Hanan-Lu/TPA311x/BOM/BOM.xlsx

Item Number | Part Number | Description | Value | Footprint | Quantity | Part Reference | Manufacturer1 | Manufacturer1 PN | Manufacturer1 Datasheet | Manufacturer2 | Manufacturer2 PN | Manufacturer2 Datasheet | Manufacturer3 | Manufacturer3 PN | Manufacturer3 Datasheet | Manufacturer4 Datasheet | Manufacturer4 | Manufacturer4 PN
1 | 01.01.000578 | THICK FILM CHIP RESISTORS, 0R, 1%, 1/10W, EIA 0603 | 0R/1% | 0603 | 6 | R13,R14,R15,R20,R24,R25 | RALEC | RTT030000FTP | https://www.ralec.com/upload/media/product/file/IE-SP-007.pdf | YAGEO
2 | 01.01.000675 | THICK FILM CHIP RESISTORS, 10R, 1%, 1/10W, EIA 0603 | 10R/1% | 0603 | 4 | R1,R2,R3,R4 | RALEC | RTT0310R0FTP | https://www.ralec.com/upload/media/product/file/IE-SP-007.pdf | YAGEO | RE0603FRE0710RL | https://www.yageo.com/upload/media/product/products/datasheet/rchip/PYu-RE_105_RoHS_L_6.pdf
3 | 01.01.000867 | THICK FILM CHIP RESISTORS, 1.00k, 1%, 1/10W, EIA 0603 | 1.00K/1% | 0603 | 2 | R28,R31 | RALEC | RTT031001FTP | https://www.ralec.com/upload/media/product/file/IE-SP-007.pdf | YAGEO | RE0603FRE071KL | https://www.yageo.com/upload/media/product/products/datasheet/rchip/PYu-RE_105_RoHS_L_6.pdf
4 | 01.01.000963 | THICK FILM CHIP RESISTORS, 10k, 1%, 1/10W, EIA 0603 | 10K/1% | 0603 | 4 | R36,R38,R56,R57 | RALEC | RTT031002FTP | https://www.ralec.com/upload/media/product/file/IE-SP-007.pdf | YAGEO | RE0603FRE0710KL | https://www.yageo.com/upload/media/product/products/datasheet/rchip/PYu-RE_105_RoHS_L_6.pdf
5 | 01.01.000992 | THICK FILM CHIP RESISTORS, 20k, 1%, 1/10W, EIA 0603 | 20K/1% | 0603 | 5 | R11,R40,R44,R51,R53 | RALEC | RTT032002FTP | https://www.ralec.com/upload/media/product/file/IE-SP-007.pdf | YAGEO | RE0603FRE0720KL | https://www.yageo.com/upload/media/product/products/datasheet/rchip/PYu-RE_105_RoHS_L_6.pdf
6 | 01.01.001059 | THICK FILM CHIP RESISTORS, 100k, 1%, 1/10W, EIA 0603 | 100K/1% | 0603 | 18 | R12,R16,R17,R18,R21,R22,R23,R26,R29,R30,R42,R43,R46,R47,R49,R50,R52,R54 | RALEC | RTT031003FTP | https://www.ralec.com/upload/media/product/file/IE-SP-007.pdf | YAGEO | RE0603FRE07100kL | https://www.yageo.com/upload/media/product/products/datasheet/rchip/PYu-RE_105_RoHS_L_6.pdf
7 | 01.01.003140 | THICK FILM CHIP RESISTORS, 0R, 1%, 3.5A, EIA 1206 | 0R/1% | 1206 | 2 | R34,R35 | RALEC | RTT060000FTP | https://www.ralec.com/upload/media/product/file/IE-SP-008.pdf
8 | 01.01.005319 | THICK FILM CHIP RESISTORS, 3.3R, 1%, 1/16W, EIA 0603 | 3.3R/1% | 0603 | 4 | R5,R6,R7,R8 | RALEC | RTT033R30FTP | https://www.ralec.com/upload/media/product/file/IE-SP-007.pdf
9 | 01.01.005377 | THICK FILM CHIP RESISTORS, 4.7k, 1%, 1/16W, EIA 0603 | 4.7k/1% | 0603 | 3 | R19,R32,R33 | RALEC | RTT034701FTP | https://www.ralec.com/upload/media/product/file/IE-SP-007.pdf
10 | 01.01.005394 | THICK FILM CHIP RESISTORS, 43k, 1%, 1/16W, EIA 0603 | 43k/1% | 0603 | 1 | R10 | RALEC | RTT034302FTP | https://www.ralec.com/upload/media/product/file/IE-SP-007.pdf
11 | 01.01.005396 | THICK FILM CHIP RESISTORS, 51k, 1%, 1/16W, EIA 0603 | 51k/1% | 0603 | 1 | R9 | RALEC | RTT035102FTP | https://www.ralec.com/upload/media/product/file/IE-SP-007.pdf
12 | 01.01.005397 | THICK FILM CHIP RESISTORS, 56k, 1%, 1/16W, EIA 0603 | 56k/1% | 0603 | 2 | R37,R39 | RALEC | RTT035602FTP | https://www.ralec.com/upload/media/product/file/IE-SP-007.pdf
13 | 01.01.005404 | THICK FILM CHIP RESISTORS, 180k, 1%, 1/16W, EIA 0603 | 180k/1% | 0603 | 2 | R41,R45 | RALEC | RTT031803FTP | https://www.ralec.com/upload/media/product/file/IE-SP-007.pdf
14 | 01.01.005708 | Rotary Potentiometers, RK09L12B0-F15-C0-B503, For Vol, ±20%, L=15mm, Horizon, RK09L12B0 | RK09L12B0-F15-C0-B503 | RK09L12 | 1 | VR1 | ALPS | RK09L12B0-F15-C0-B503 | https://tech.alpsalpine.com/prod/c/pdf/potentiometer/rotarypotentiometers/rk09l/rk09l.pdf
15 | 01.02.000094 | GP MLCC, 1uF, 16V, 10%, X7R, EIA 0603 | 1uF/16V | 0603 | 2 | C23,C24 | Samaung | CL10B105KO8NNN | http://weblib.samsungsem.com/mlcc/mlcc-ec-data-sheet.do?partNumber=CL10B105KO8NNN
16 | 01.02.000109 | GP MLCC, 330pF, 50V, 10%, X7R, EIA 0603 | 330pF/50V | 0603 | 4 | C2,C4,C6,C8 | Samaung | CL10B331KB8NNN | http://weblib.samsungsem.com/mlcc/mlcc-ec-data-sheet.do?partNumber=CL10B331KB8NNN
17 | 01.02.000113 | GP MLCC, 1nF, 50V, 10%, X7R, EIA 0603 | 1nF/50V | 0603 | 2 | C19,C22 | Samaung | CL10B102KB8NNN | http://weblib.samsungsem.com/mlcc/mlcc-ec-data-sheet.do?partNumber=CL10B102KB8NNN
18 | 01.02.000124 | GP MLCC, 10nF, 50V, 10%, X7R, EIA 0603 | 10nF/50V | 0603 | 4 | C13,C14,C15,C16 | Samaung | CL10B103KB8NNN | http://weblib.samsungsem.com/mlcc/mlcc-ec-data-sheet.do?partNumber=CL10B103KB8NNN
19 | 01.02.000134 | GP MLCC, 100nF, 50V, 10%, X7R, EIA 0603 | 100nF/50V | 0603 | 6 | C18,C21,C30,C47,C48,C54 | Samaung | CL10B104KB8NNN | http://weblib.samsungsem.com/mlcc/mlcc-ec-data-sheet.do?partNumber=CL10B104KB8NNN
20 | 01.02.000135 | GP MLCC, 220nF, 50V, 10%, X7R, EIA 0603 | 220nF/50V | 0603 | 6 | C1,C3,C5,C7,C33,C40 | Samaung | CL10B224KB8NNN | http://weblib.samsungsem.com/mlcc/mlcc-ec-data-sheet.do?partNumber=CL10B224KB8NNN
21 | 01.02.000140 | GP MLCC, 3.3uF/10V, 10%, X7R, EIA 0805 | 3.3uF/10V | 0805 | 4 | C26,C27,C28,C29 | Samaung | CL21B335KPFNNN | http://weblib.samsungsem.com/mlcc/mlcc-ec-data-sheet.do?partNumber=CL21B335KPFNNN
22 | 01.02.000195 | GP MLCC, 680nF/50V, 10%, X7R, EIA 0805 | 680nF/50V | 0805 | 4 | C9,C10,C11,C12 | Samaung | CL21B684KBFNNN | http://weblib.samsungsem.com/mlcc/mlcc-ec-data-sheet.do?partNumber=CL21B684KBFNNN
23 | 01.02.000235 | GP MLCC, 10uF, 50V, 10%, X7R, EIA 1206 | 10uF/50V | 1206 | 2 | C39,C46 | Samaung | CL31B106KBHNNN | http://weblib.samsungsem.com/mlcc/mlcc-ec-data-sheet.do?partNumber=CL31B106KBHNNN
24 | 01.02.000362 | GP MLCC, 22uF, 25V ±20%, X5R, EIA 0805 | 22uF/25V | 0805 | 10 | C34,C35,C36,C37,C41,C42,C43,C44,C49,C53 | Samaung | CL21A226MAYNNNE | http://weblib.samsungsem.com/mlcc/mlcc-ec-data-sheet.do?partNumber=CL21A226MAYNNN
25 | 01.02.000654 | GP MLCC, 47pF, 50V, ±5%, C0G, EIA 0603 | 47pF/50V | 0603 | 3 | C25,C38,C45 | Samaung | CL10C470JB8NFN | http://weblib.samsungsem.com/mlcc/mlcc-ec-data-sheet.do?partNumber=CL10C470JB8NFN
26 | 01.02.000773 | Radial Aluminum Electrolytic Capacitors-40~85℃, 2000H, 1000uF, 35V, 12.5X20.0mm | 1000uF/35V | 12.5X20.0 | 4 | C17,C20,C31,C32 | Panasonic | ECA1VM102 | https://industrial.panasonic.cn/cdbs/www-data/pdf/RDF0000/ABA0000C1220.pdf
27 | 01.04.000398 | SMT Shielded Power Inductor, 10uH, 30mΩ, 7.8A, 11.5x10.0x3.8mm | 10uH/7.8A | 1040 | 4 | L1,L2,L3,L4 | Cjiang | FXL1040-100-M | http://www.cjiang.tw/uploadfile/file/20190305/6368737812760517663312034.pdf | WE | 74437368100 | https://www.we-online.com/catalog/datasheet/74437368100.pdf | Sunlord | MWSA1004C-100MT | https://atta.szlcsc.com/upload/public/pdf/source/20180327/C151872_2907C77BE933212C728C209604192B1D.pdf
28 | 01.04.000413 | SMT Shielded Power Inductor, 100uH, ±20%, 0.45Ω, 0.45A, 7.0x7.0x3.2mm | 100uH/0.45A | 7032 | 2 | L5,L6 | TDK | SLF7032T-101MR45-2PF | https://product.tdk.com/system/files/dam/doc/product/inductor/inductor/smd/catalog/inductor_commercial_power_slf7032_en.pdf
29 | 01.05.000004 | Schottky Diodes, SS14, 40V, 1A, SMA(DO214AC) | SS14 | SMA | 2 | D7,D8 | ON Semiconductor | SS14 | https://www.onsemi.com/pub/Collateral/SS19-D.PDF | Vishay | SS14 | https://www.vishay.com/docs/88746/ss12.pdf
30 | 01.05.000027 | Zener Diode, 7.5V, 500mW, SOD123 | MMSZ5236BT1G | SOD-123 | 1 | D4 | ON Semiconductor | MMSZ5236BT1G | https://www.onsemi.cn/pdf/datasheet/mmsz5221bt1-d.pdf
31 | 01.05.000031 | Zener Diode, 10V, 500mW, SOD123 | MMSZ5240BT1G | SOD-123 | 2 | D3,D9 | ON Semiconductor | MMSZ5240BT1G | https://www.onsemi.cn/pdf/datasheet/mmsz5221bt1-d.pdf
32 | 01.06.000037 | LED, Side, Clear,方形, Red, 631nm, VF=2V, EIA 0603, Height=0.6mm | Red | 0603 | 3 | D6,D11,D12 | Everlight | 27-21/R6C-AP1Q2B/3C | https://everlighteurope.com/index.php?controller=attachment&id_attachment=5791 | Wurth | 155060RS75300 | https://www.we-online.com/catalog/datasheet/155060RS75300.pdf
33 | 01.06.000038 | LED, Side, Clear,方形, Green, 571nm, VF=2V, EIA 0603, Height=0.6mm | Green | 0603 | 1 | D5 | Everlight | 27-21/G6C-AN1P1/3C | https://everlighteurope.com/pcb/2725/27-21-G6C-AN1P1-3C.html | Wurth | 155060VS75300 | https://www.we-online.com/catalog/datasheet/155060VS75300.pdf
34 | 01.07.000008 | MMBT3904L, NPN Transistor, VCE饱和电压: 0.3V, Ic: 0.2A, VCEO: 40V, VCBO: 60V, VEBO: 6V, SOT23-3 | MMBT3904L | SOT-23-3 | 3 | Q1,Q2,Q3 | ON Semiconductor | MMBT3904L | https://www.onsemi.com/pub/Collateral/MMBT3904LT1-D.PDF
35 | 01.08.000180 | Single P Channel MOSFET, NCE40P13S, VBR(DS):-40V, Vgs(th):-1.7V, Id:-13A, SOP-8 | NCE40P13S | SOP-8 | 1 | Q4 | NCE | NCE40P13S | http://www.ncepower.com/upload/cn/propdf/NCE40P13S.pdf
36 | 01.09.000105 | Step Down DC-DC Converter, ME3116AM6G, VIN:4.75~40V, VFB=0.8V, IMAX=1A, SOT23-6 | ME3116AM6G | SOT23-6 | 2 | U2,U3 | MicroOne | ME3116AM6G | https://www.semiee.com/file/MicrOne/MicrOne-ME3116_C6.0.pdf
37 | 01.10.000125 | Class D Stereo Amplifier, TPA3116D2DAD, 15W/30W/50W Filter Free, With AM Avoidance, HTSSOP32-EP | TPA3116D2DAD | HTSSOP32-EP | 1 | U1 | TI | TPA3116D2DADR | https://www.ti.com.cn/cn/lit/ds/symlink/tpa3116d2.pdf
38 | 01.10.000154 | Hi-Fi Audio OP-Amp, Dual, LM4562MAX/NOPB, GBW:55MHz, VCC:5~34V, SR:±20V/us, SOIC-8 | LM4562MAX/NOPB | SOIC-8 | 1 | U4 | TI | LM4562MAX/NOPB | https://www.ti.com.cn/cn/lit/ds/symlink/lm4562.pdf
39 | 01.12.000623 | PCB Terminal Blocks, Spring Clamp System, 5.08mm, 4P, 300V, 10A, DG142R-5.08-04P | DG142R-5.08-04P | DG142R-508P-4N | 1 | J1 | Degson | DG142R-5.08-04P | https://www.degson.com.cn/index.php?a=downloadFile&id=819937&name=%27ZmlsZTQ=%27 | KEFA | KF142R-5.08-04P | http://www.cnkefa.com/ueditor/php/upload/file/20210919/1632039788290723.pdf | Amphenol | HA0401500000G | http://www.anytek.com.cn/UserUpFiles/20181025/hneMBnFDKulB.pdf
40 | 01.12.000643 | DC Power Jack, 10A, 36VDC, ID:2.5mm, OD 6.5mm | DC-053D-25A | PJ-082BH | 1 | J4 | HRO | DC-053D-25A | http://www.krhro.com/uploads/soft/180521/1-1P521151527.pdf | CUI Devices | PJ-082BH | https://www.cuidevices.com/product/resource/pj-082bh.pdf
41 | 01.12.000644 | 3.5mm Phone Jack, SMT Type, PJ-393-8A, 4 Connector, With SPST | PJ-393-8A | PJ-393-8A | 1 | J5 | HRO | PJ-393-8A | http://www.krhro.com/uploads/soft/180312/1-1P312140044.pdf
42 | 01.13.000116 | THT Push Switch, Horizon, XKBS22E05-W, No Lock, DC 50V, 0.3A, Travel 3.5mm | XKBS22E05-Z | XKBS22E05 | 1 | SW1 | XKB | XKBS22E05-Z | http://www.helloxkb.com/public/images/pdf/XKBS22E05-X.pdf
43 | 02.01.000022 | Virtual Components, M3 Screw Hole | M3 |  | 4 | M1,M2,M3,M4
44 | 02.02.000077 | Heat Sink, For TPA311x, 13.9x50x25mm, D=40mm, M3*2 | ATS-TI10P-521-C1-R1 |  | 1 | HEATSINK1 | ATS | ATS-TI10P-521-C1-R1 | https://www.qats.com/DataSheet/ATS-TI1OP-521-C1-R1
