Hanan-Lu/TPA311x/SCH/TPA3116-SCH-A0.pdf

Analog +5V And -5V SUPPLYPower IN And ON/OFF Control C33 | Audio Input And Pre-Amp -5V

# Power ON & LVP

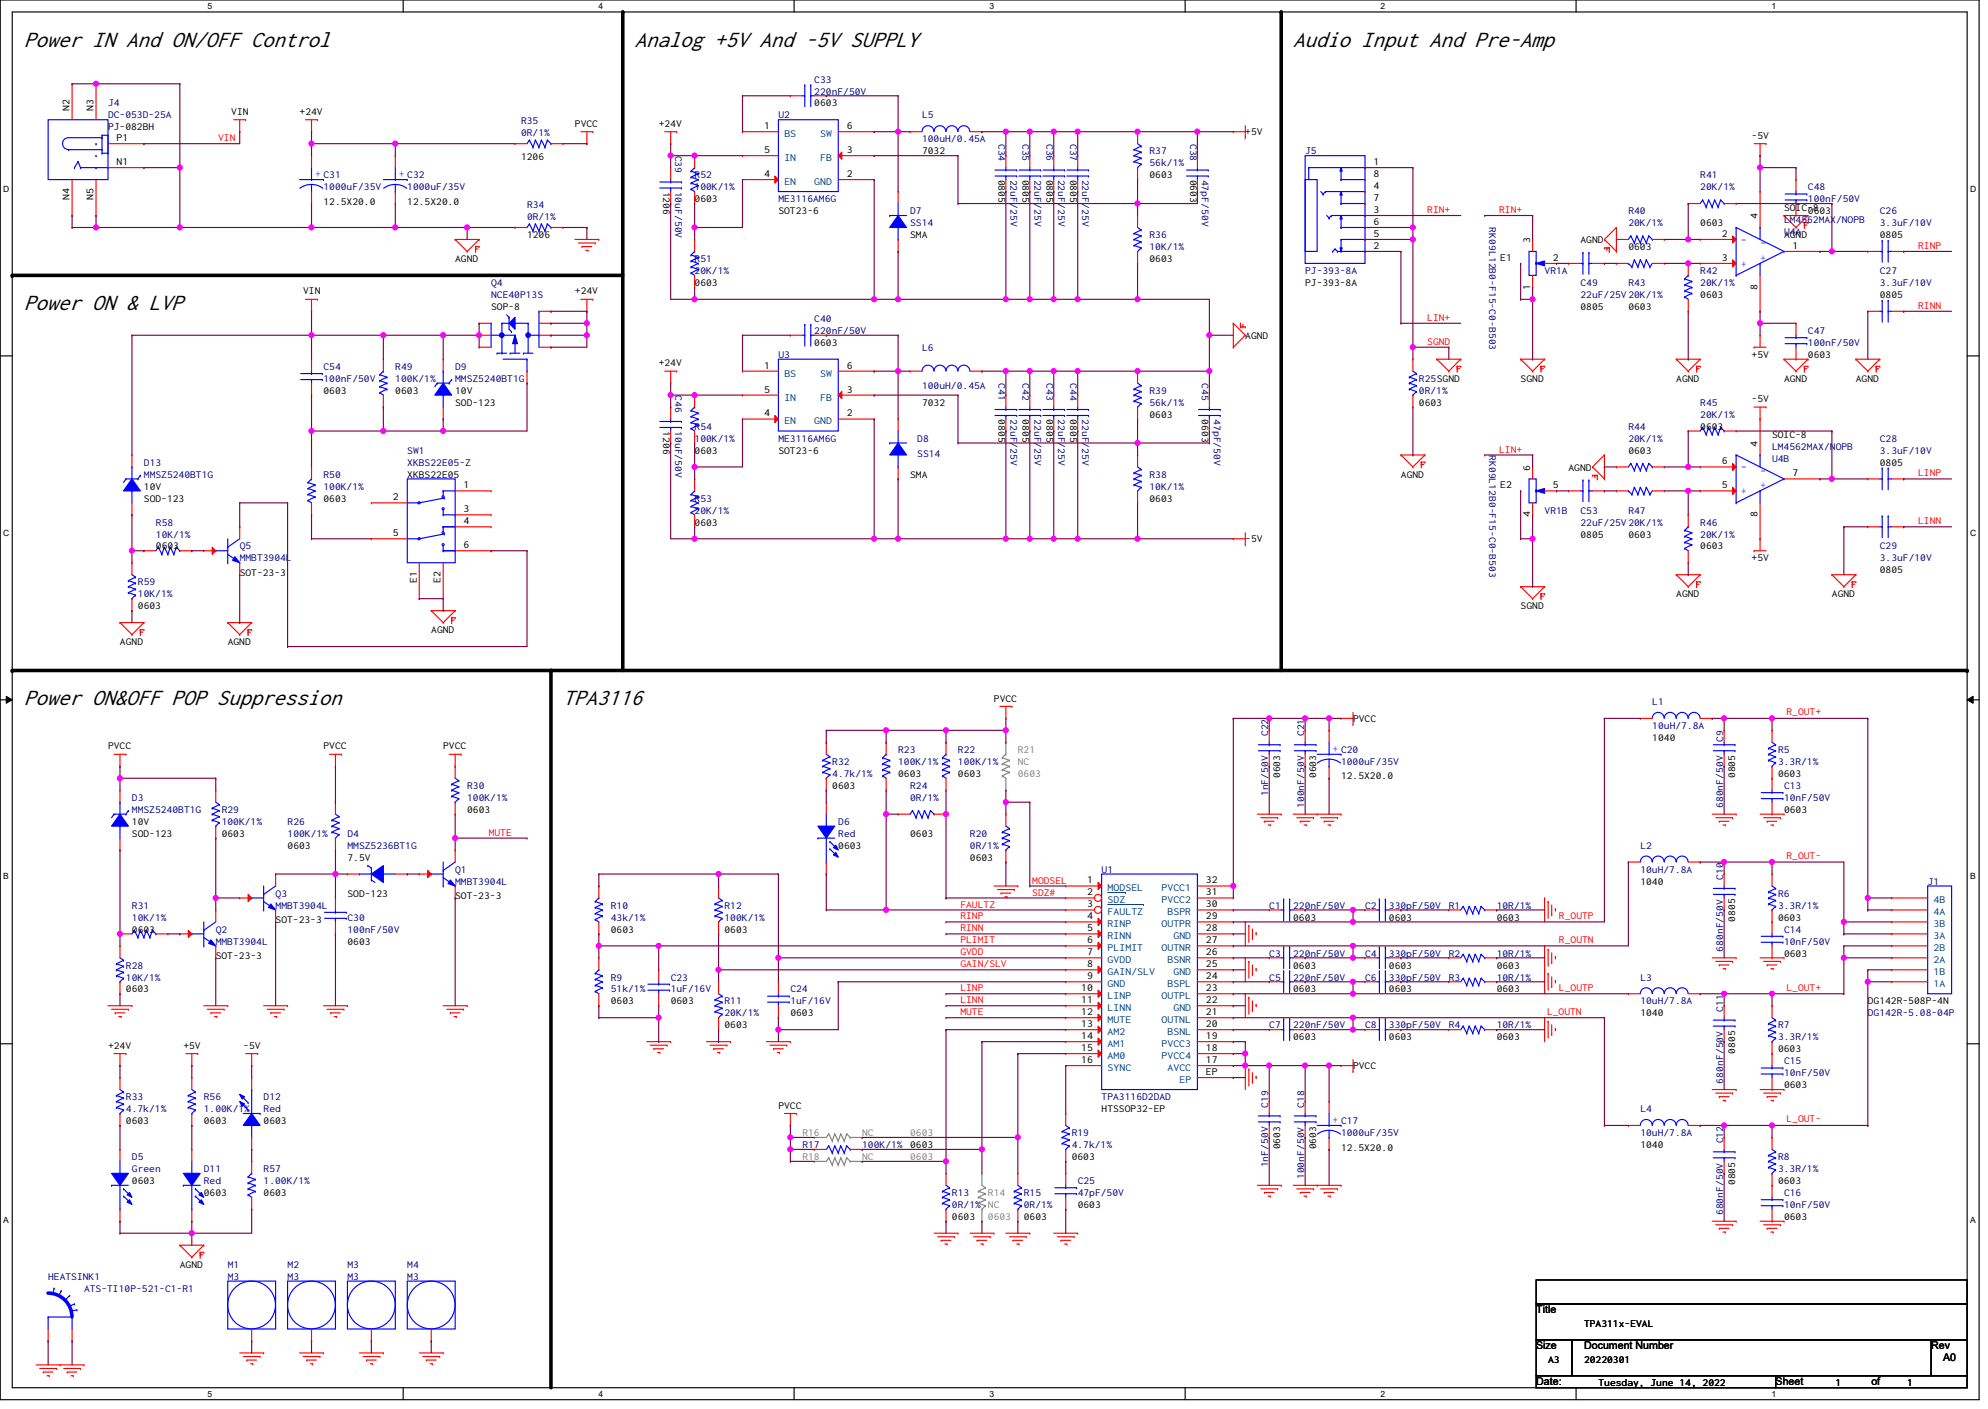
[picture p5: page 1]

TPA3116Power ON&OFF POP Suppression
