Hanan-Lu/TPA311x/(list of files, drawings)

Other design files:
SCH/TPA3116-SCH-A0.DSN
